RamonJOrtega/panTiltRobot/Mirrored pan-tilt camera stabilization.pptx

## Mirrored pan-tilt camera tracking

Ramon Ortega
Grant Latham

## Agenda

- The whys and the wherefores
- The Jungle
- The justification of the means

## Motivation

- Existing camera gimbal systems are large, heavy, and relatively slow.
- Rotating small mirrors is much easier than rotating the entire camera
- If the system is sufficiently small and lightweight, it can be packaged in a handheld system

## Methods

- System components
- Two servo motors to rotate the mirrors
- IMU to measure motion
- Arduino Uno to interface IMU with servos
- Two types of operation addressed
- Stationary camera, moving target
  - Characterized step response and maximum rotation speed
- Stationary target, moving camera
  - Full, if imperfect implementation

## Machine Components

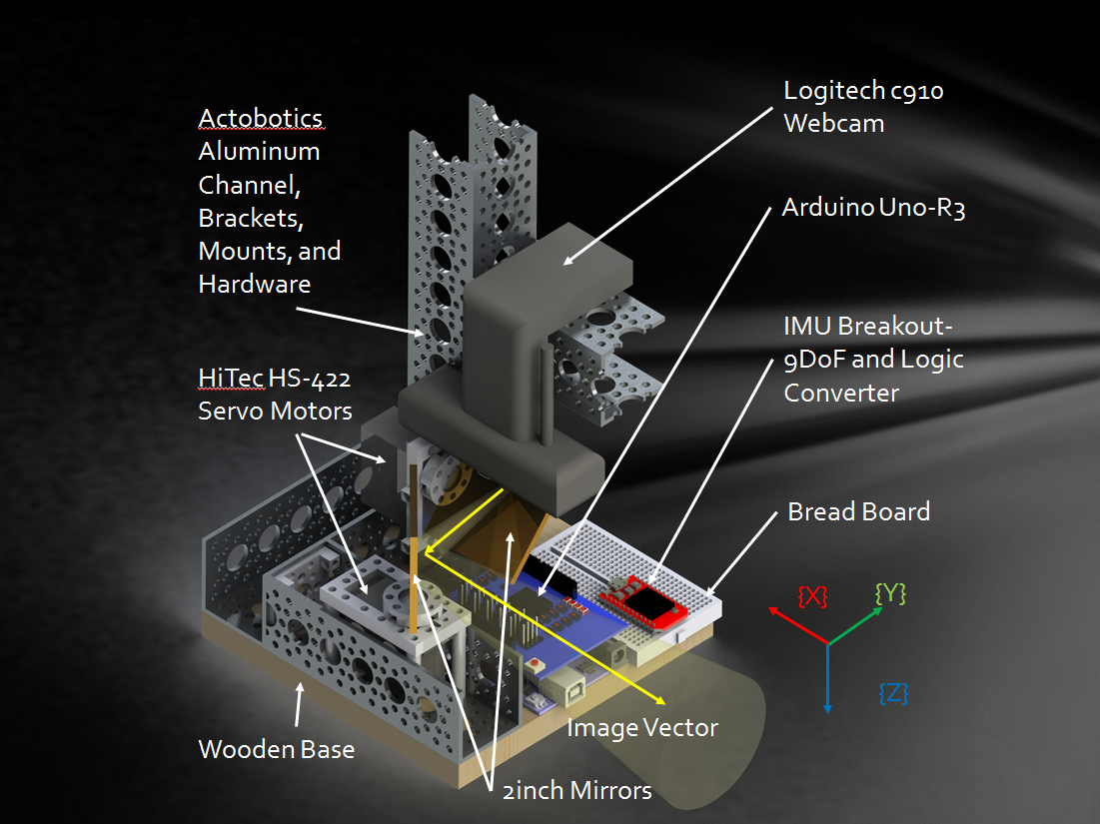
[picture p4: figure]

## Commanding Servos for Image Satiation of Stationary Target

Θ

Upper servo angle controlled by pitch from accelerometer

Upper servo angle controlled by yaw from gyroscope

{ay}machine

{X}world

{az}machine

{X}world

{ry}machine

{Y}world

{Y}world

{rz}machine

{Z}world

{Z}world

{ax}machine

R

R onZ

{rx}machine

g

## Results

- Step response data

G=0.972/(0.0359s+1)

## Results

- Camera motion compensation was qualitatively successful with rotations of ±30° . Response time was slower than desired, but this is likely due to low quality components.

## The Prestige
