RamonJOrtega/panTiltRobot/System Picture.png

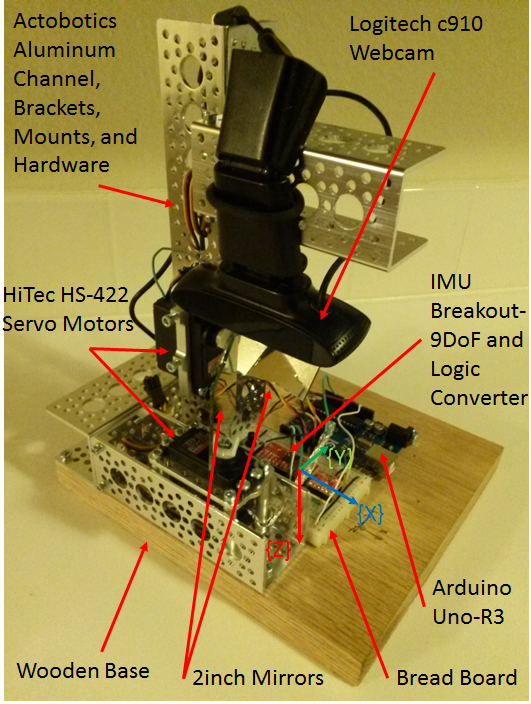
System Picture.png
