RamonJOrtega/panTiltRobot/Wiring Diagram.pptx

Analogue Position Feedback

PWM Signal

Analogue Position Feedback

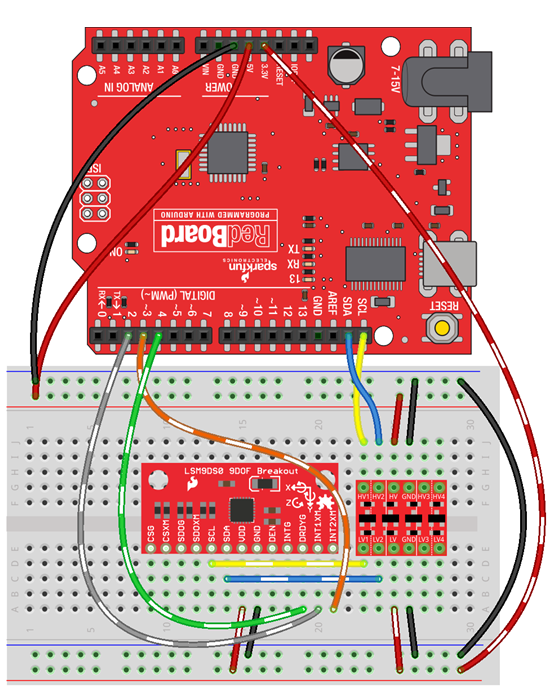
[picture p12: figure]

7-12V Power Source

PWM Signal

Lower Servo Motor

5V Rail

Upper Servo Motor

5V Rail

USB

Ground

Ground

Ground

3.3V Rail
