RamonJOrtega/panTiltRobot/(commit log)

2022-12-08 update wiring diagram
2022-12-08 add BOM picture
2023-07-11 Update README.md
    update arduino C in readme
